olagd/praca_dyplomowa/board_src/board-Czujnik temperatury.pdf

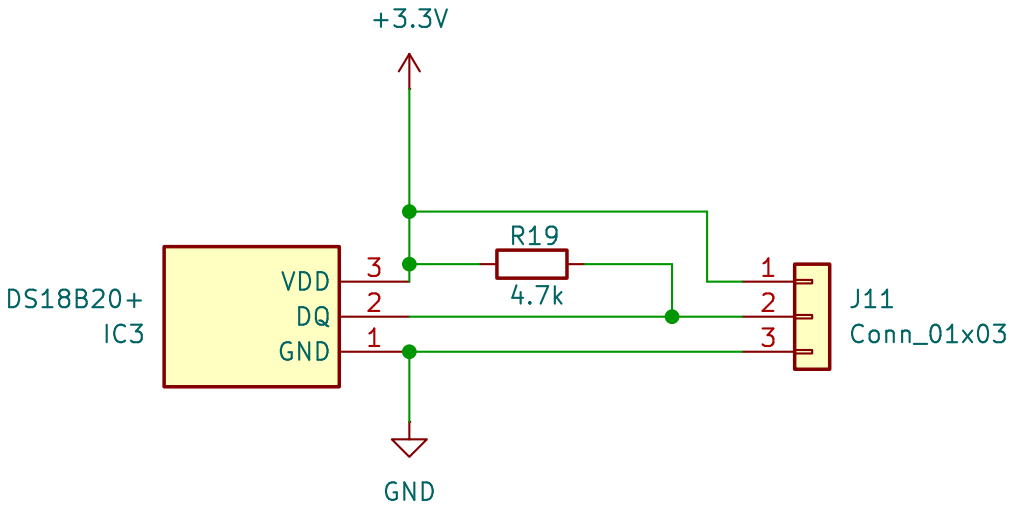
[picture p9: page 1]
