olagd/praca_dyplomowa/board_src/board-Przetwornik analogowo-cyfrowy.pdf

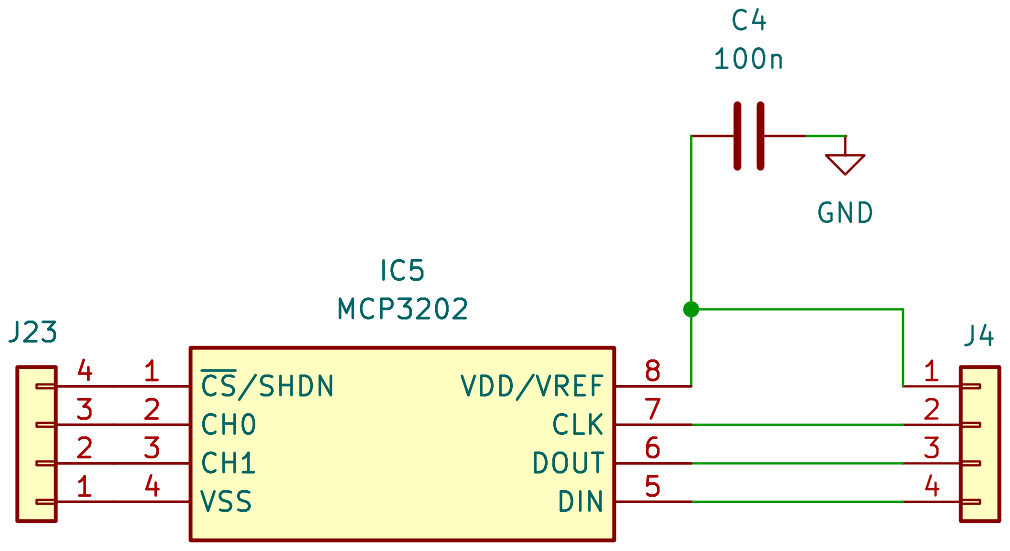
[picture p10: page 1]

2 2 | 3
1 1 | 4
