olagd/praca_dyplomowa/(commit log)

2025-03-11 Wersja początkowa
    [board.kicad_pcb, board.kicad_sch, eeprom.kicad_sch, pcf.kicad_sch, rtc.kicad_sch, untitled.kicad_sch, wyswietlacz.kicad_sch]
2025-03-11 Wersja początkowa 9.0
    [board.kicad_pcb, board.kicad_sch, eeprom.kicad_sch, rtc.kicad_sch, untitled.kicad_sch]
2025-03-14 wersja dodane arkusze hierarchiczne
    [board.kicad_pcb, board.kicad_sch, buzzer.kicad_sch, eeprom.kicad_sch, microSD.kicad_sch, potencjometry.kicad_sch, rtc.kicad_sch, untitled.kicad_sch]
2025-03-25 wersja dodane USB i port szeregowy
    [board.kicad_pcb, board.kicad_sch, portUSB.kicad_sch, portszeregowy.kicad_sch]
2025-03-25 wersja z przetwornikiem
    [board.kicad_pcb, board.kicad_sch, led.kicad_sch, przetwornik.kicad_sch, wyświetlacz.kicad_sch]
2025-03-25 wersja uzupelnione footprinty
    [board.kicad_pcb, board.kicad_sch, eeprom.kicad_sch, microSD.kicad_sch, portUSB.kicad_sch, potencjometry.kicad_sch, przetwornik.kicad_sch, przyciski.kicad_sch]
2025-03-31 wersja 3d
    [board.kicad_pcb, board.kicad_sch, eeprom.kicad_sch, led.kicad_sch, microSD.kicad_sch, portUSB.kicad_sch, potencjometry.kicad_sch, przyciski.kicad_sch]
2025-04-01 uporzadkowane 3D
    [board.kicad_pcb, board.kicad_sch, eeprom.kicad_sch, microSD.kicad_sch, portUSB.kicad_sch]
2025-04-03 wersja z wyswietlaczem LCD
    [board.kicad_pcb, board.kicad_sch, eeprom.kicad_sch, led.kicad_sch, microSD.kicad_sch, potencjometry.kicad_sch, rgb.kicad_sch, rtc.kicad_sch]
2025-04-07 wersja z FT232RN
    [board.kicad_pcb, board.kicad_sch, eeprom.kicad_sch, led.kicad_sch, microSD.kicad_sch, portUSB.kicad_sch, potencjometry.kicad_sch, przetwornik.kicad_sch]
2025-04-29 Wersja ze sciezkami miedzianymi
    [board.kicad_pcb, board.kicad_sch, eeprom.kicad_sch, led.kicad_sch, microSD.kicad_sch, portUSB.kicad_sch, potencjometry.kicad_sch, przetwornik_CA.kicad_sch]
2025-05-07 sciezki polaczen
    [board.kicad_pcb, board.kicad_sch, eeprom.kicad_sch, potencjometry.kicad_sch, rtc.kicad_sch, wyswietlaczlcd.kicad_sch]
2025-05-08 poprawione polaczenia diod i wartosci opornikow, aktualizacja niektorych elementow ze wzgledu na braki w magazynie
    [board.kicad_pcb, board.kicad_sch, eeprom.kicad_sch, led.kicad_sch, portUSB.kicad_sch, potencjometry.kicad_sch, przetwornik_CA.kicad_sch, przyciski.kicad_sch]
2025-05-15 dodany tranzystor BS123
    [board-B_Cu.gbr, board-B_Mask.gbr, board-B_Paste.gbr, board-B_Silkscreen.gbr, board-Edge_Cuts.gbr, board-F_Cu.gbr, board-F_Mask.gbr, board-F_Paste.gbr]
2025-05-22 najnowsza wersja
    [board.kicad_pcb, board.kicad_sch, wyswietlaczlcd.kicad_sch, wyswietlaczled.kicad_sch]
2025-05-29 finalna wersja, naniesione poprawki
    [board.kicad_pcb, wyswietlaczlcd.kicad_sch, wyświetlacz.kicad_sch]
2025-06-14 Poprawki w schematach. Rozpoczęte korekty płytki
    [board.kicad_pcb, board.kicad_sch, eeprom.kicad_sch, led.kicad_sch, microSD.kicad_sch, portUSB.kicad_sch, potencjometry.kicad_sch, przetwornik.kicad_sch]
2025-06-16 Naniesione poprawki na projekcie płytki. Wersja końcowa
    [board-B_Cu.gbl, board-B_Cu.gbr, board-B_Mask.gbr, board-B_Paste.gbr, board-B_Silkscreen.gbr, board-Edge_Cuts.gbr, board-F_Cu.gbr, board-F_Cu.gtl]
2025-06-16 Wprowadzono usprawnienia i poprawki. Wersja ostateczna, wysłana do JLCPCB.
    [board.kicad_pcb, board.kicad_sch, eeprom.kicad_sch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]
